alxsh/balmer-usb-sdr/doc/trx2-dds-1-sch.pdf

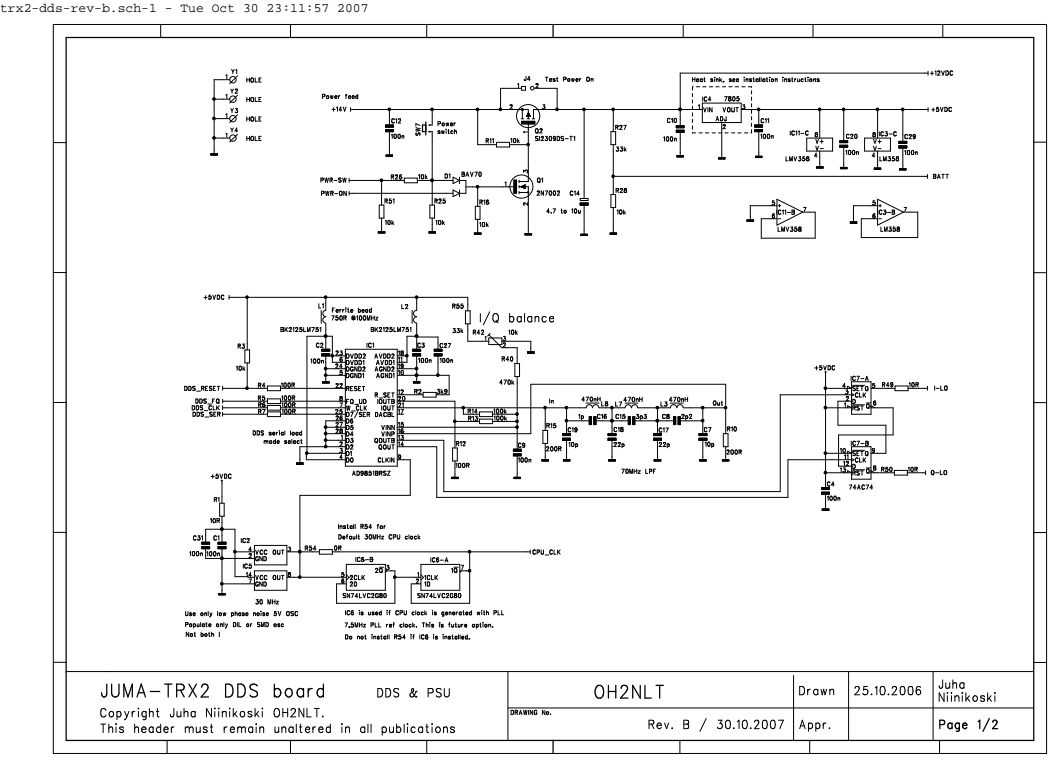
[picture p10: page 1]

trx2-dds-rev-b.sch-1 - Tue Oct 30 23:11:57 2007
