alxsh/balmer-usb-sdr/circuit/ADC_DSP.brd

## EAGLE design circuit/ADC_DSP.brd (2015-01-28)

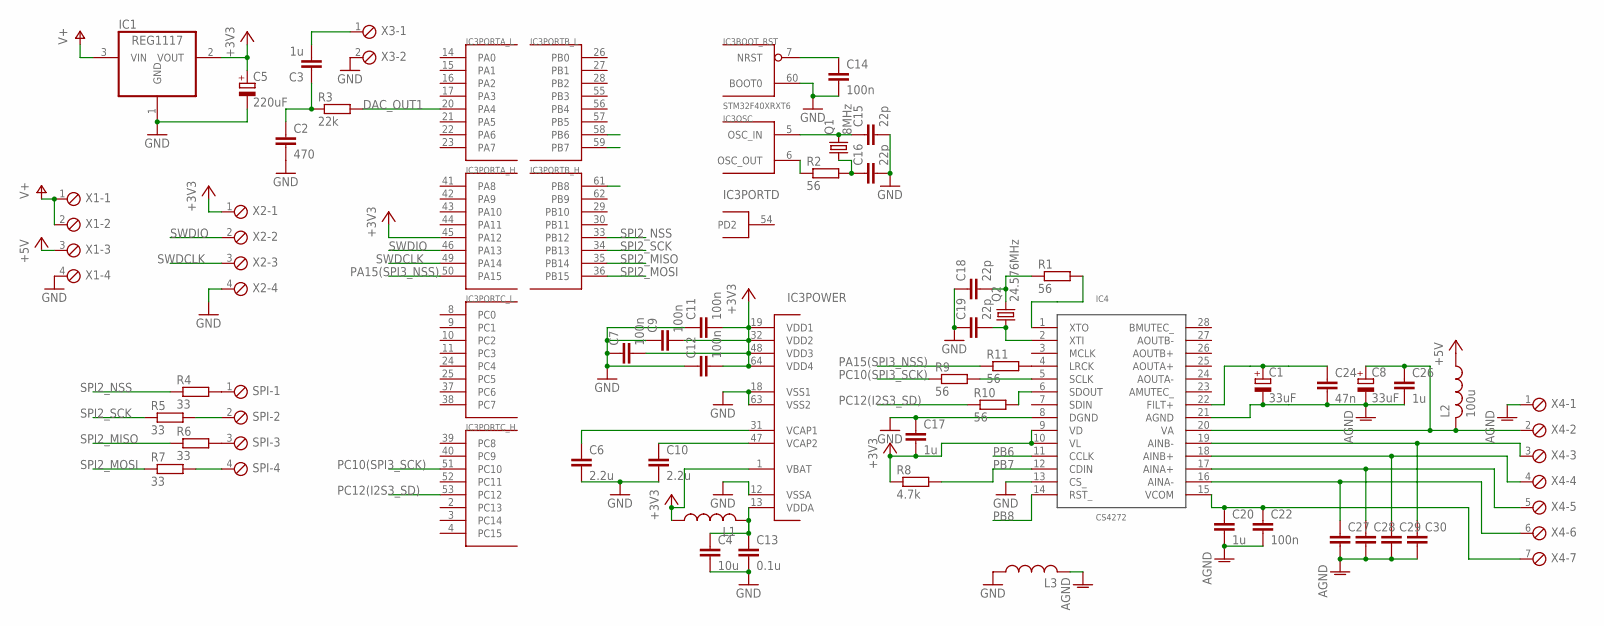
[picture p11: schematic ADC_DSP.sch]

Parts:
C1, C8: 33uF; 153CLV-0605
C2: 470; C0603
C3, C17, C20, C26: 1u; C0603
C4: 10u; C0805
C5: 220uF; 153CLV-0605
C6, C10: 2.2u; C0603
C7, C9, C11, C12, C14, C22: 100n; C0603
C13: 0.1u; C0603
C15, C16, C18, C19: 22p; C0603
C24: 47n; C0805
C27, C28, C29, C30: C-EUC0805; C0805
IC1: REG1117; SOT223
IC3: STM32F40XRXT6; TQFP64
IC4: CS4272; TSSOP28
L1, L3: L-USL2012C; L2012C
L2: 100u; 0207/12
Q1: 8MHz; HC49/S
Q2: 24.576MHz; HC49/S
R1, R2, R9, R10, R11: 56; R0603
R3: 22k; R0603
R4, R5, R6, R7: 33; R0603
R8: 4.7k; R0603
SPI: MPT4; 4POL254
X1, X2: MPT4; 4POL254
X3: MPT2; 2POL254
X4: MPT7; 7POL254

Connections:
+3V3: C5.+, C7.2, C9.2, C11.2, C12.2, C17.2, IC1.2 (VOUT), IC3.1 (VBAT), IC3.19 (VDD1), IC3.32 (VDD2), IC3.45 (PA12), IC3.48 (VDD3), IC3.64 (VDD4), IC4.9 (VD), IC4.10 (VL), L1.1, R8.1, X2.1
+5V: L2.1, X1.3
AGND: C1.-, C8.-, C20.2, C22.2, C24.2, C26.2, C27.2, C28.2, C29.2, C30.2, IC4.21 (AGND), L3.2, X4.1
AINA+: C28.1, IC4.17 (AINA+), X4.5
AINB+: C29.1, IC4.18 (AINB+), X4.4
AVCC: C8.+, C26.1, IC4.20 (VA), L2.2, X4.2
DAC_OUT1: IC3.20 (PA4), R3.2
GND: C2.2, C4.2, C5.-, C6.2, C7.1, C9.1, C10.2, C11.1, C12.1, C13.2, C14.2, C15.2, C16.2, C17.1, C18.1, C19.1, IC1.1 (GND), IC3.12 (VSSA), IC3.18 (VSS1), IC3.60 (BOOT0), IC3.63 (VSS2), IC4.8 (DGND), IC4.13 (CS_), L3.1, X1.4, X2.4, X3.2
unnamed: C10.1, IC3.47 (VCAP2)
unnamed: C6.1, IC3.31 (VCAP1)
unnamed: C4.1, C13.1, IC3.13 (VDDA), L1.2
unnamed: C14.1, IC3.7 (NRST)
unnamed: C15.1, IC3.5 (OSC_IN), Q1.2
unnamed: C16.1, Q1.1, R2.2
unnamed: C19.2, IC4.2 (XTI), Q2.1
unnamed: C18.2, Q2.2, R1.1
unnamed: IC4.4 (LRCK), R11.2
unnamed: IC4.5 (SCLK), R9.2
unnamed: IC4.6 (SDOUT), R10.2
unnamed: C1.+, C24.1, IC4.22 (FILT+)
unnamed: C30.1, IC4.19 (AINB-), X4.3
unnamed: C3.2, X3.1
unnamed: IC4.1 (XTO), R1.2
unnamed: C27.1, IC4.16 (AINA-), X4.6
unnamed: IC3.6 (OSC_OUT), R2.1
unnamed: R4.2, SPI.1
unnamed: R5.2, SPI.2
unnamed: R6.2, SPI.3
unnamed: C2.1, C3.1, R3.1
unnamed: R7.2, SPI.4
PA15(SPI3_NSS): IC3.50 (PA15), R11.1
PB6: IC3.58 (PB6), IC4.11 (CCLK)
PB7: IC3.59 (PB7), IC4.12 (CDIN), R8.2
PB8: IC3.61 (PB8), IC4.14 (RST_)
PC10(SPI3_SCK): IC3.51 (PC10), R9.1
PC12(I2S3_SD): IC3.53 (PC12), R10.1
SPI2_MISO: IC3.35 (PB14), R6.1
SPI2_MOSI: IC3.36 (PB15), R7.1
SPI2_NSS: IC3.33 (PB12), R4.1
SPI2_SCK: IC3.34 (PB13), R5.1
SWDCLK: IC3.49 (PA14), X2.3
SWDIO: IC3.46 (PA13), X2.2
V+: IC1.3 (VIN), X1.1, X1.2
VCOM: C20.1, C22.1, IC4.15 (VCOM), X4.7

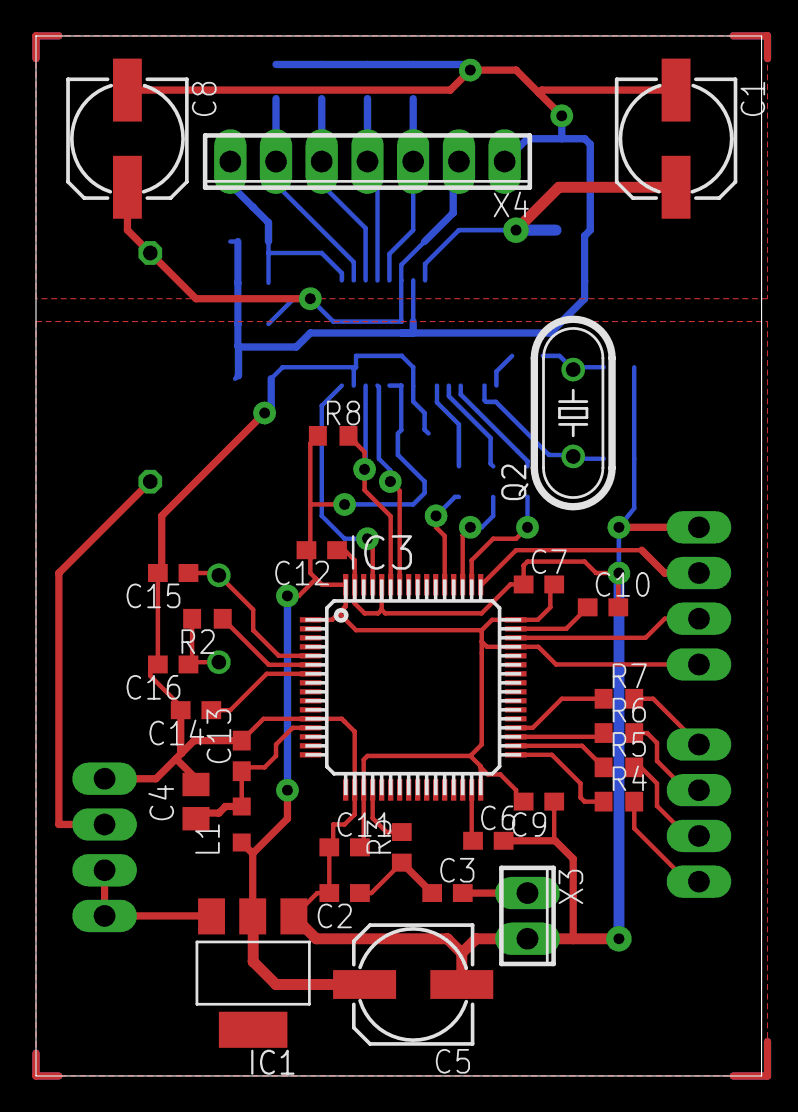
[picture p12: board ADC_DSP.brd from above]

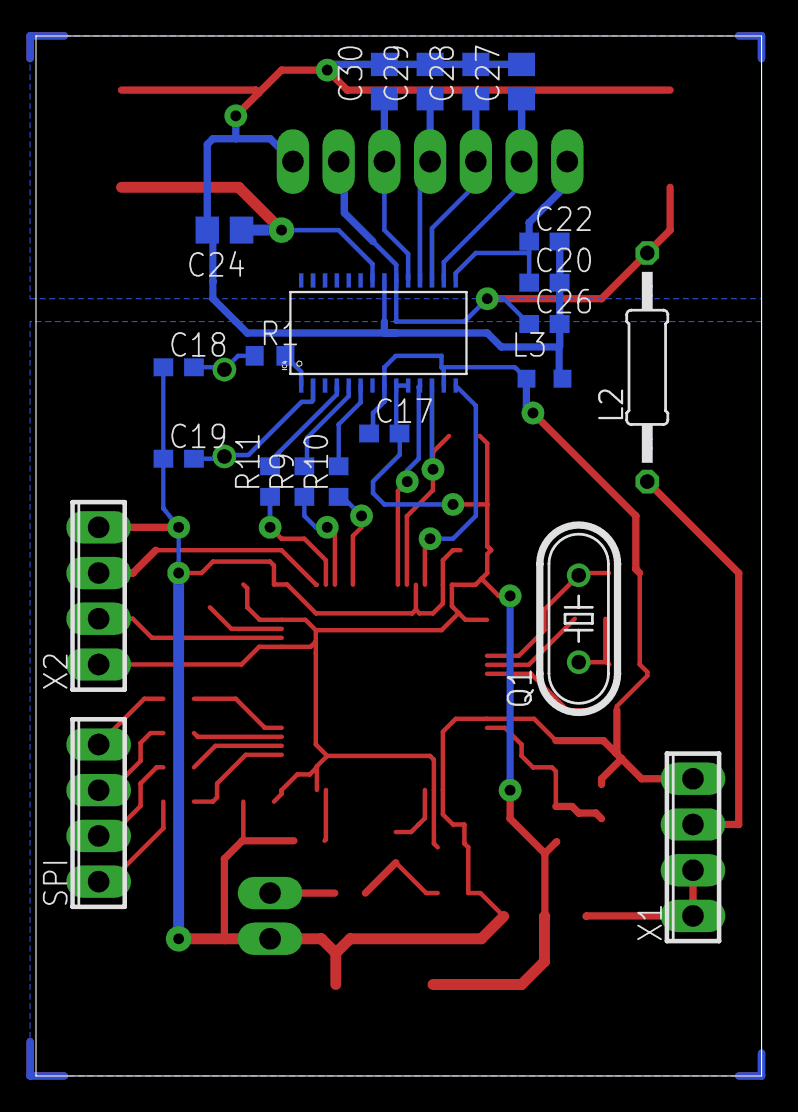
[picture p13: board ADC_DSP.brd from below]

Board: 2 copper layers, 40.3 x 57.8 mm, 51 parts (22 on the bottom side), 44 nets.
