alxsh/balmer-usb-sdr/circuit/mixer.brd

## EAGLE design circuit/mixer.brd (2014-12-01)

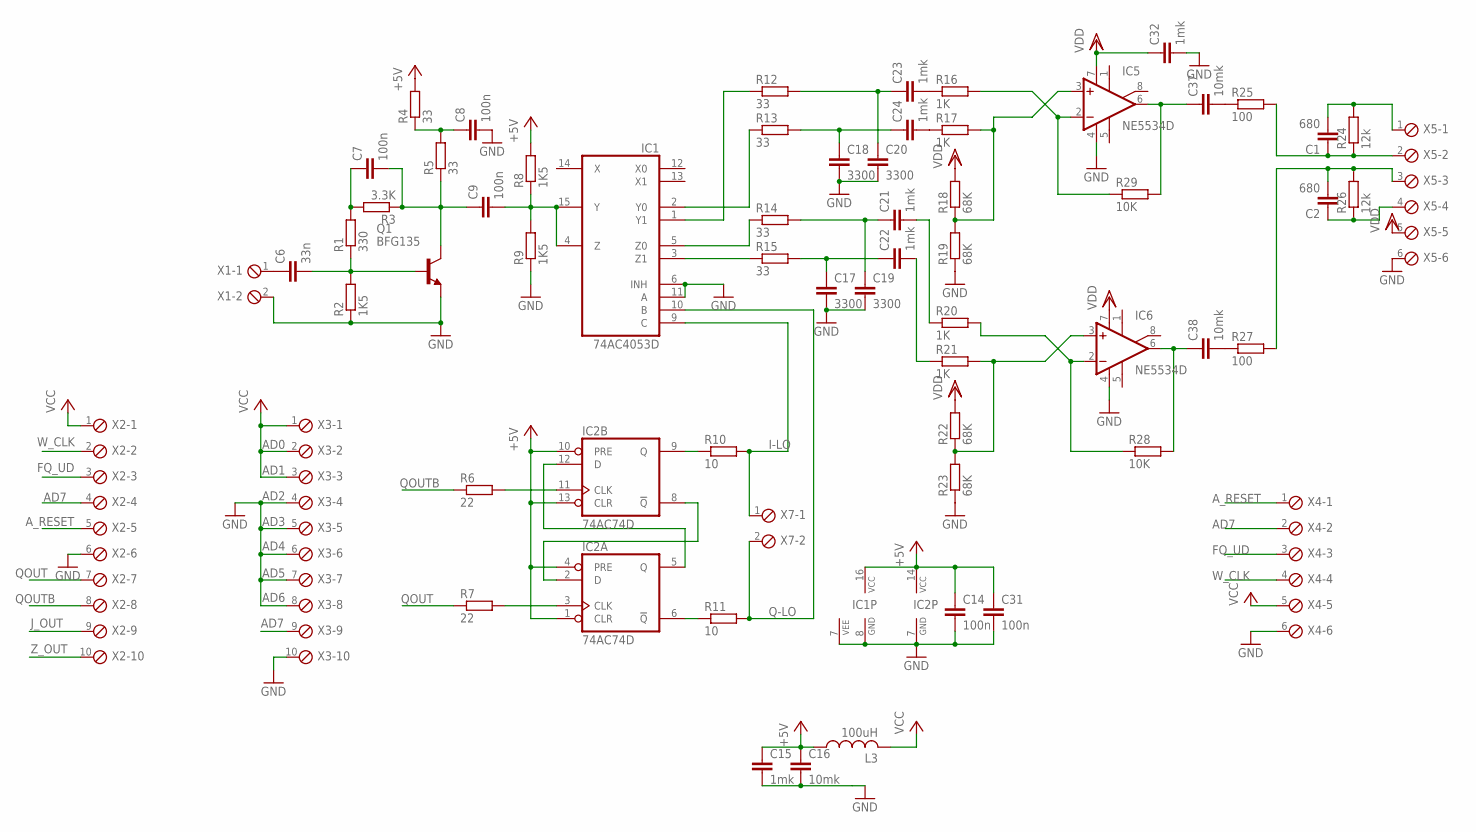
[picture p14: schematic mixer.sch]

Parts:
C1, C2: 680; C0805
C6: 33n; C0805
C7, C8, C9, C14, C31: 100n; C0603
C15, C21, C22, C23, C24, C32: 1mk; C0603
C16, C37, C38: 10mk; C0805
C17, C18, C19, C20: 3300; C0805
IC1: 74AC4053D; SO16
IC2: 74AC74D; SO14
IC5, IC6: NE5534D; SO08
L3: 100uH; 0207/12
Q1: BFG135; SOT223
R1: 330; R0603
R2, R8, R9: 1K5; R0603
R3: 3.3K; R0603
R4, R5, R12, R13, R14, R15: 33; R0603
R6, R7: 22; R0603
R10, R11: 10; R0603
R16, R17, R20, R21: 1K; R0603
R18, R19, R22, R23: 68K; R0603
R24, R26: 12k; R0603
R25, R27: 100; R0603
R28, R29: 10K; R0603
X1, X7: MPT2; 2POL254
X2, X3: MPT10; 10POL254
X4, X5: MPT6; 6POL254

Connections:
+5V: C14.1, C15.1, C16.1, C31.1, IC1.16 (VCC), IC2.1 (CLR), IC2.4 (PRE), IC2.10 (PRE), IC2.13 (CLR), IC2.14 (VCC), L3.1, R4.2, R8.2
AD7: X2.4, X4.2
A_RESET: X2.5, X4.1
FQ_UD: X2.3, X4.3
GND: C8.2, C14.2, C15.2, C16.2, C17.2, C18.2, C19.2, C20.2, C31.2, C32.2, IC1.6 (INH), IC1.7 (VEE), IC1.8 (GND), IC1.11 (A), IC2.7 (GND), IC5.4 (V-), IC6.4 (V-), Q1.1 (E), Q1.3 (E), R2.1, R9.1, R19.1, R23.1, X1.2, X2.6, X3.4, X3.5, X3.6, X3.7, X3.8, X3.10, X4.6, X5.6
I-LO: IC1.9 (C), R10.2, X7.1
J_OUT: X2.9
unnamed: IC2.5 (Q), IC2.12 (D)
unnamed: IC2.2 (D), IC2.8 (!Q)
unnamed: IC2.11 (CLK), R6.2
unnamed: IC2.3 (CLK), R7.2
unnamed: IC1.3 (Z1), R15.1
unnamed: C9.2, IC1.4 (Z), IC1.15 (Y), R8.1, R9.2
unnamed: C7.1, R1.2, R3.2
unnamed: IC1.5 (Z0), R14.1
unnamed: IC1.2 (Y0), R13.1
unnamed: IC1.1 (Y1), R12.1
unnamed: C17.1, C22.1, R15.2
unnamed: C19.1, C21.1, R14.2
unnamed: C18.1, C24.1, R13.2
unnamed: C20.1, C23.1, R12.2
unnamed: IC5.3 (+IN), R17.2, R18.1, R19.2
unnamed: C38.1, IC6.6 (OUT), R28.2
unnamed: IC5.2 (-IN), R16.2, R29.1
unnamed: C37.1, IC5.6 (OUT), R29.2
unnamed: C23.2, R16.1
unnamed: C21.2, R20.1
unnamed: C22.2, R21.1
unnamed: IC6.2 (-IN), R20.2, R28.1
unnamed: IC6.3 (+IN), R21.2, R22.1, R23.2
unnamed: C6.1, X1.1
unnamed: C24.2, R17.1
unnamed: C37.2, R25.1
unnamed: C1.1, R24.1, R25.2, X5.2
unnamed: C1.2, R24.2, X5.1
unnamed: C2.1, R26.1, X5.4
unnamed: C2.2, R26.2, R27.2, X5.3
unnamed: IC2.9 (Q), R10.1
unnamed: IC2.6 (!Q), R11.1
unnamed: C38.2, R27.1
unnamed: C7.2, C9.1, Q1.4 (C), R3.1, R5.1
unnamed: C8.1, R4.1, R5.2
unnamed: C6.2, Q1.2 (B), R1.1, R2.2
Q-LO: IC1.10 (B), R11.2, X7.2
QOUT: R7.1, X2.7
QOUTB: R6.1, X2.8
VCC: L3.2, X2.1, X3.1, X3.2, X3.3, X4.5
VDD: C32.1, IC5.7 (V+), IC6.7 (V+), R18.2, R22.2, X5.5
W_CLK: X2.2, X4.4
Z_OUT: X2.10

Notes on the sheet:
AD0
AD1
AD2
AD3
AD4
AD5
AD6
AD7

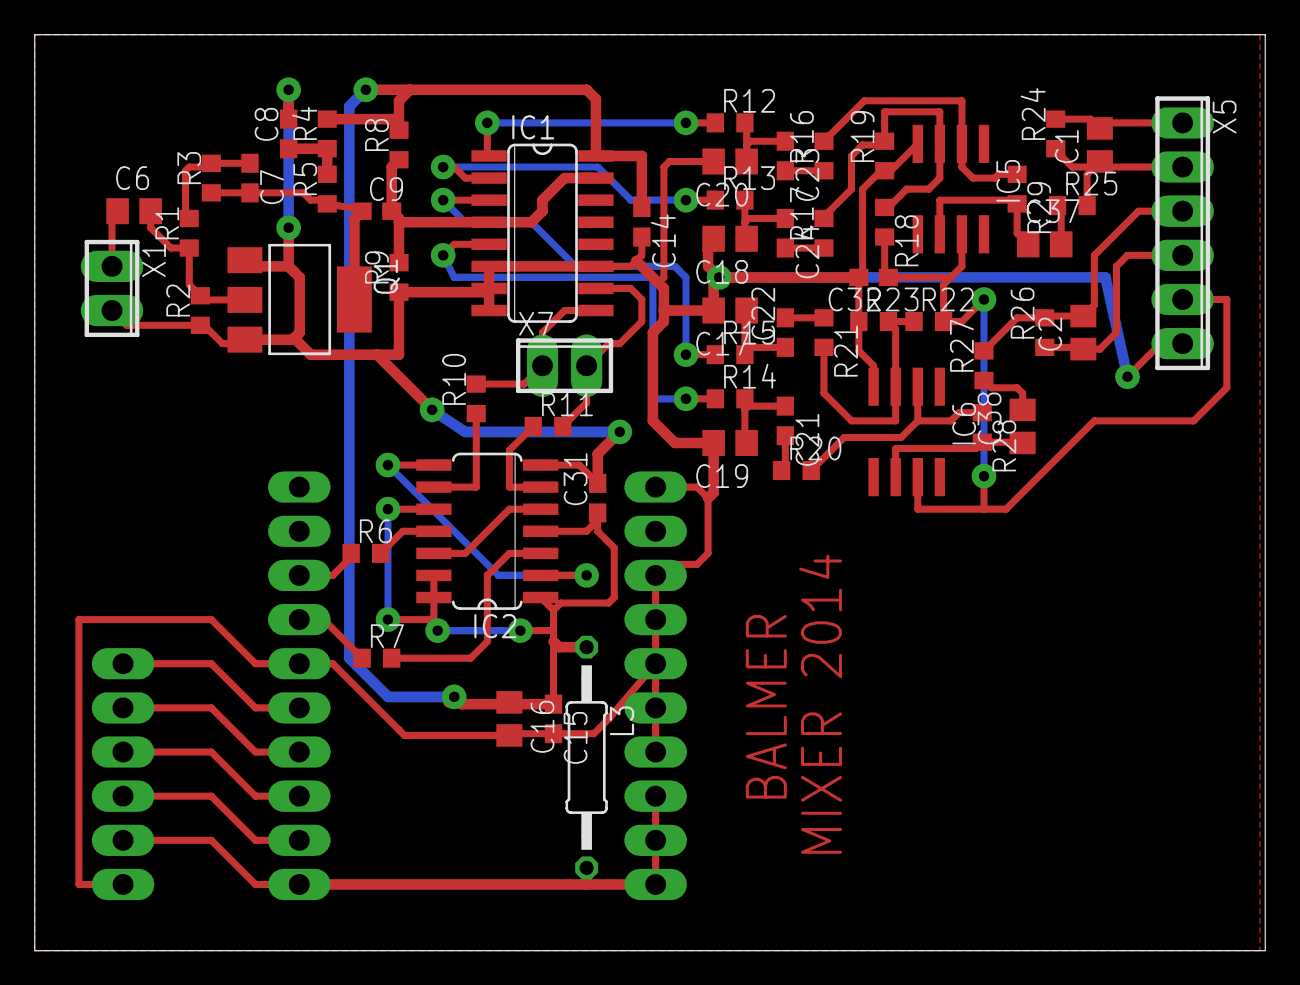
[picture p15: board mixer.brd from above]

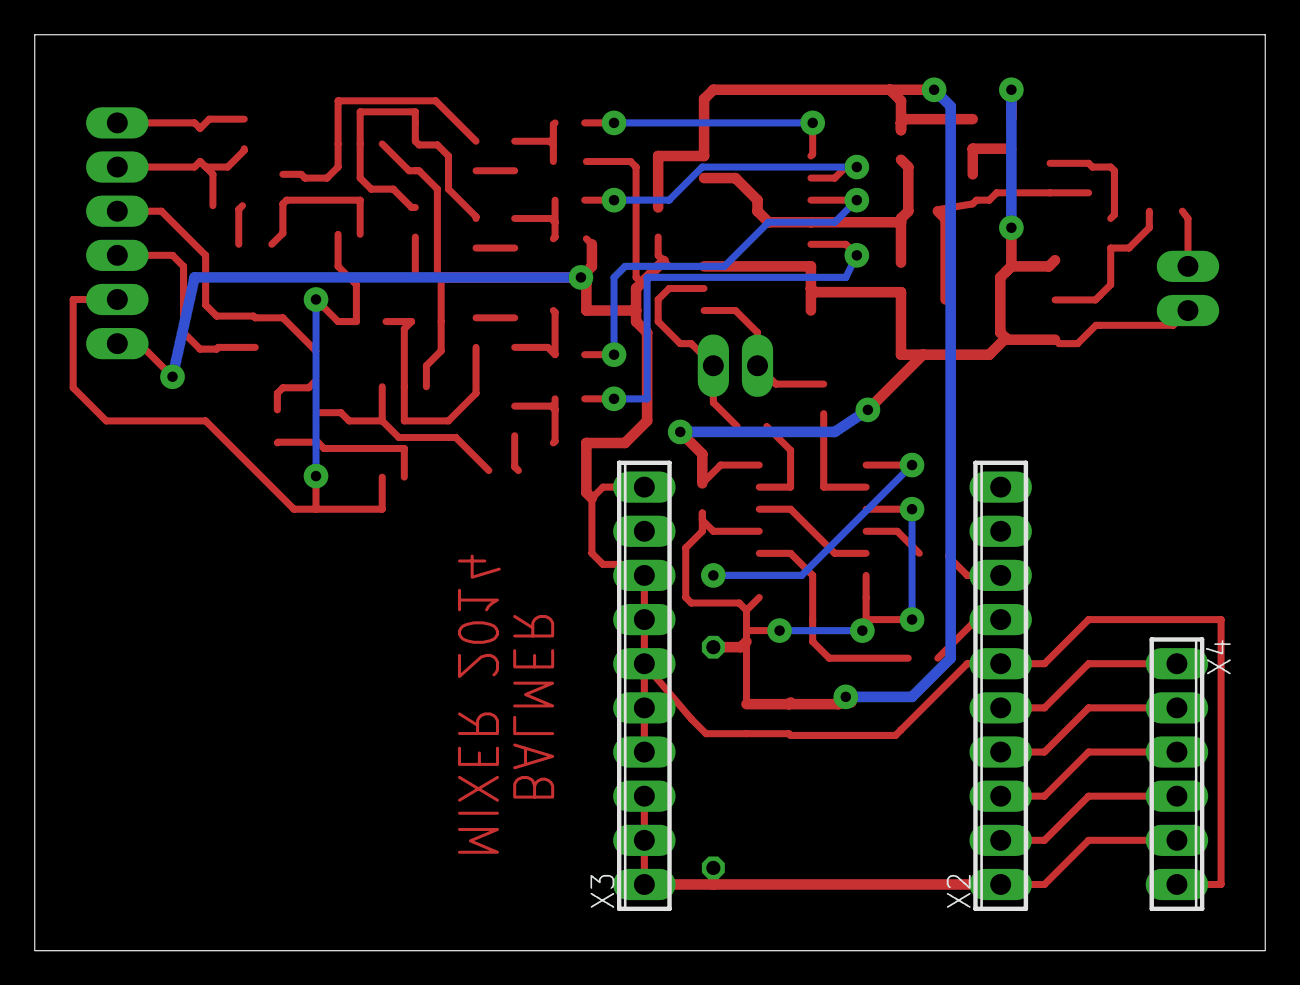
[picture p16: board mixer.brd from below]

Board: 2 copper layers, 70.8 x 52.7 mm, 62 parts (3 on the bottom side), 48 nets.
