alxsh/balmer-usb-sdr/circuit/dual_supply.brd

## EAGLE design circuit/dual_supply.brd (2014-11-25)

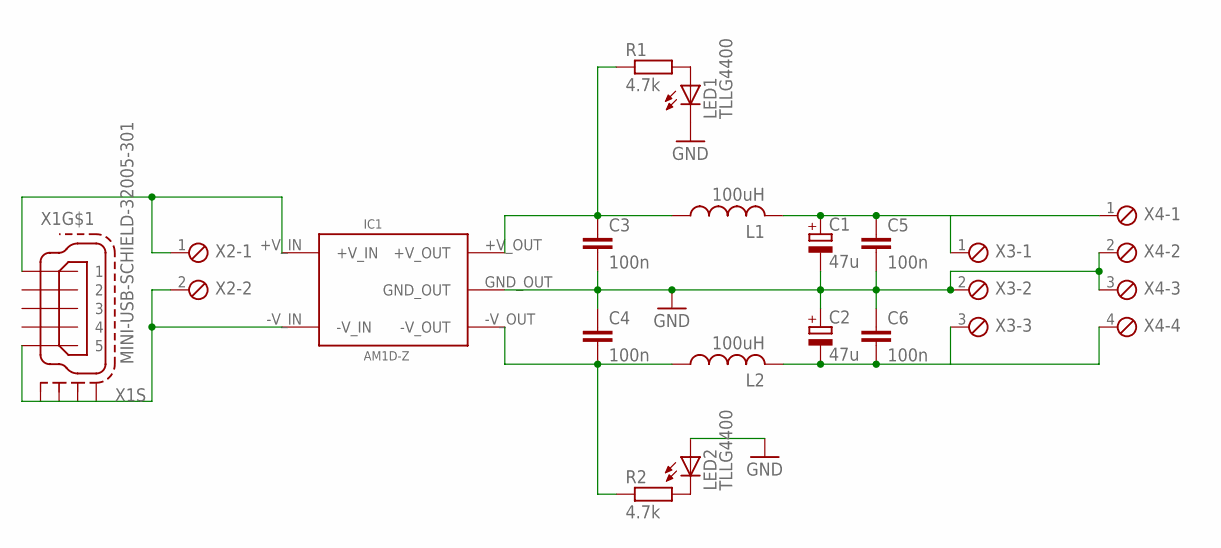
[picture p17: schematic dual_supply.sch]

Parts:
C1, C2: 47u; E3,5-8
C3, C4, C5, C6: 100n; C0805
IC1: AM1D-Z
L1, L2: 100uH; IR-2
LED1, LED2: TLLG4400; LED3MM
R1, R2: 4.7k; R0805
X1: MINI-USB-SCHIELD-32005-301; 32005-301
X2: MPT2; 2POL254
X3: MPT3; 3POL254
X4: MPT4; 4POL254

Connections:
+5V: C1.+, C5.1, L1.2, X3.1, X4.1
-5V: C2.-, C6.2, L2.2, X3.3, X4.4
GND: C1.-, C2.+, C3.2, C4.1, C5.2, C6.1, IC1.GND_OUT, LED1.K (C), LED2.A, X3.2, X4.2, X4.3
unnamed: IC1.-V_IN, X1.5, X1.M1 (S1), X1.M2 (S2), X1.M3 (S3), X1.M4 (S4), X2.2
unnamed: IC1.+V_IN, X1.1, X2.1
unnamed: C3.1, IC1.+V_OUT, L1.1, R1.1
unnamed: LED1.A, R1.2
unnamed: C4.2, IC1.-V_OUT, L2.1, R2.1
unnamed: LED2.K (C), R2.2

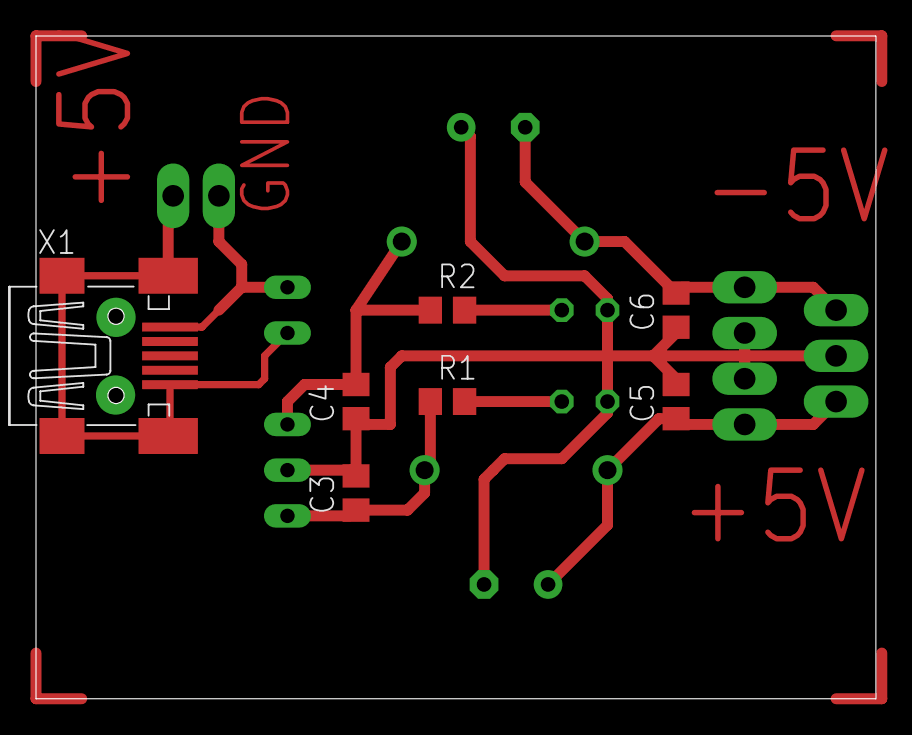
[picture p18: board dual_supply.brd from above]

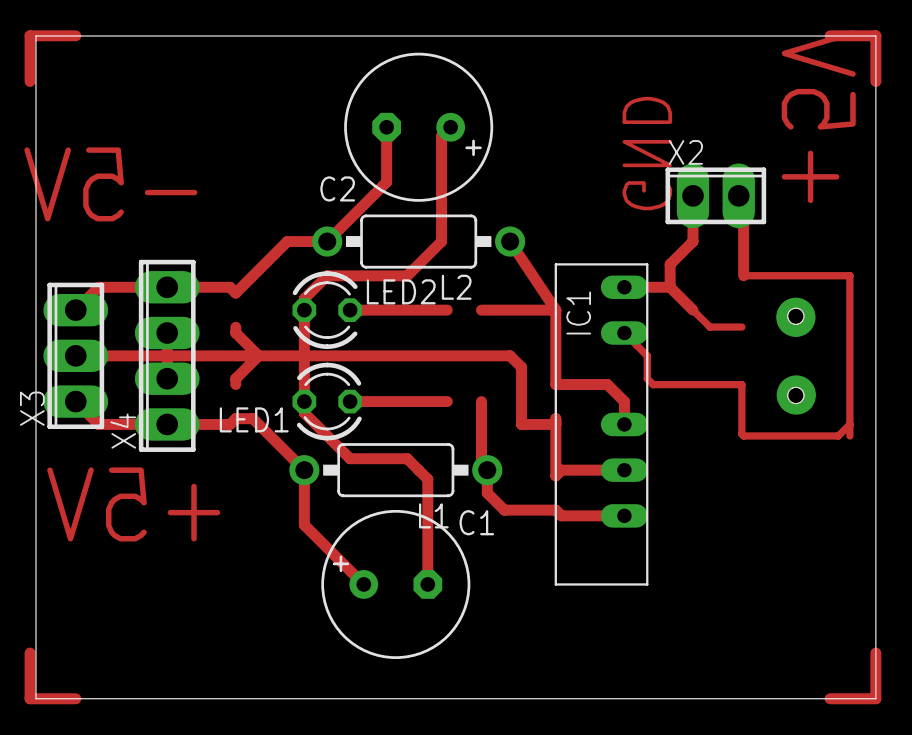
[picture p19: board dual_supply.brd from below]

Board: 2 copper layers, 46.7 x 36.8 mm, 17 parts (10 on the bottom side), 9 nets.
