alxsh/balmer-usb-sdr/circuit/cs4272_test.brd

## EAGLE design circuit/cs4272_test.brd (2014-10-25)

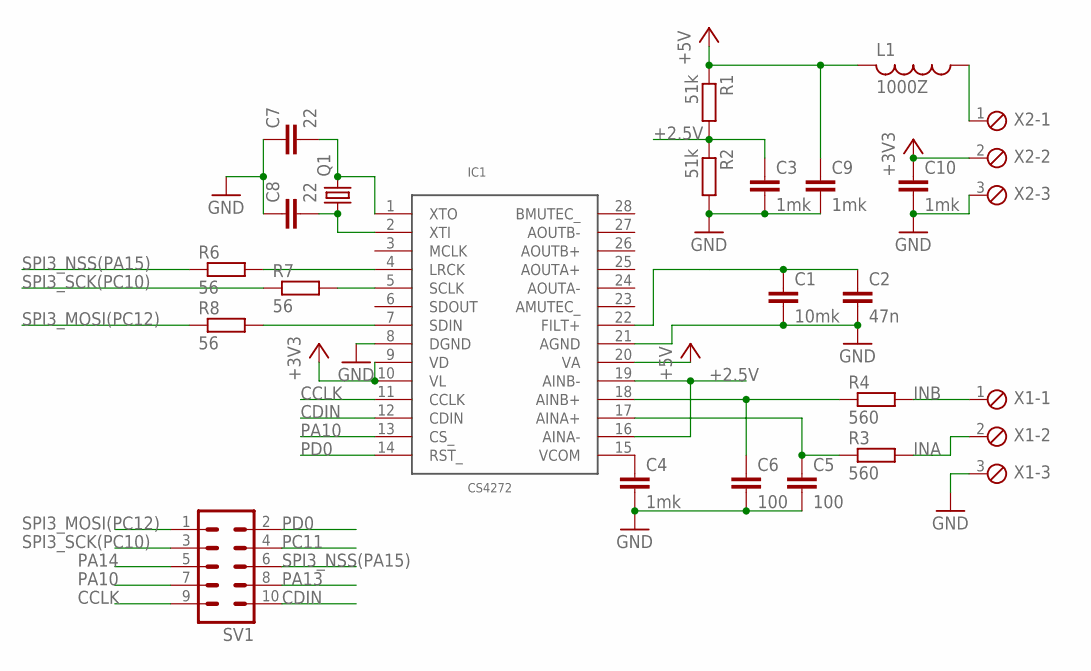
[picture p20: schematic cs4272_test.sch]

Parts:
C1: 10mk; C0805
C2: 47n; C0805
C3, C4, C9, C10: 1mk; C0603
C5, C6: 100; C0805
C7, C8: 22; C0603
IC1: CS4272; TSSOP28
L1: 1000Z; C0805
Q1: CRYSTALHC49S; HC49/S
R1, R2: 51k; R0603
R3, R4: 560; R0603
R6, R7, R8: 56; R0603
SV1: ML10
X1, X2: MPT3; 3POL254

Connections:
+2.5V: C3.1, IC1.16 (AINA-), IC1.19 (AINB-), R1.2, R2.1
+3V3: C10.1, IC1.9 (VD), IC1.10 (VL), X2.2
+5V: C9.1, IC1.20 (VA), L1.2, R1.1
CCLK: IC1.11 (CCLK), SV1.9
CDIN: IC1.12 (CDIN), SV1.10
GND: C1.2, C2.2, C3.2, C4.2, C5.2, C6.2, C7.1, C8.1, C9.2, C10.2, IC1.8 (DGND), IC1.21 (AGND), R2.2, X1.3, X2.3
INA: R3.2, X1.2
INB: R4.2, X1.1
unnamed: C1.1, C2.1, IC1.22 (FILT+)
unnamed: C4.1, IC1.15 (VCOM)
unnamed: C6.1, IC1.18 (AINB+), R4.1
unnamed: C5.1, IC1.17 (AINA+), R3.1
unnamed: C8.2, IC1.2 (XTI), Q1.1
unnamed: C7.2, IC1.1 (XTO), Q1.2
unnamed: L1.1, X2.1
unnamed: IC1.4 (LRCK), R6.2
unnamed: IC1.5 (SCLK), R7.2
unnamed: IC1.7 (SDIN), R8.2
PA10: IC1.13 (CS_), SV1.7
PA13: SV1.8
PA14: SV1.5
PC11: SV1.4
PD0: IC1.14 (RST_), SV1.2
SPI3_MOSI(PC12): R8.1, SV1.1
SPI3_NSS(PA15): R6.1, SV1.6
SPI3_SCK(PC10): R7.1, SV1.3

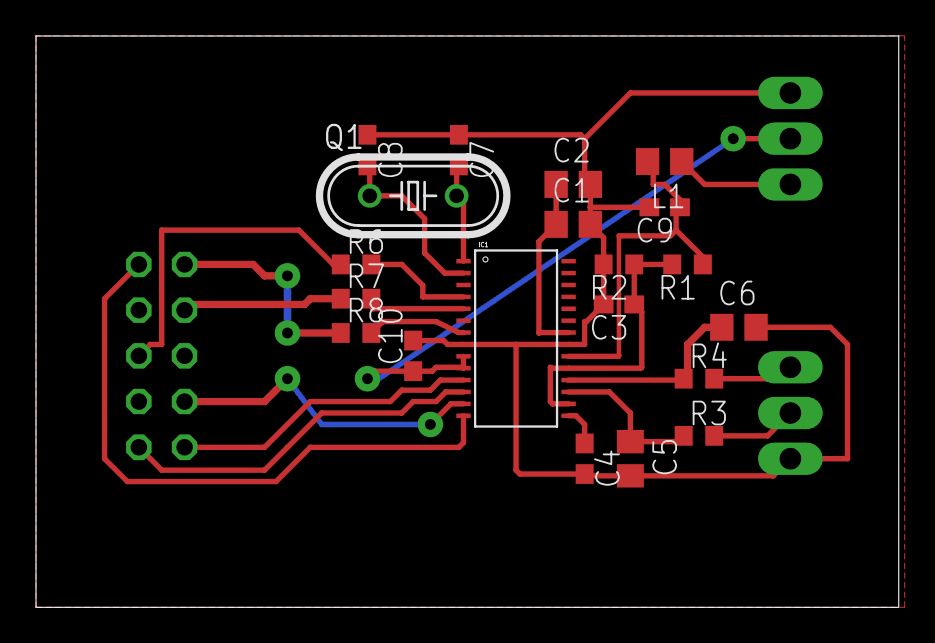
[picture p21: board cs4272_test.brd from above]

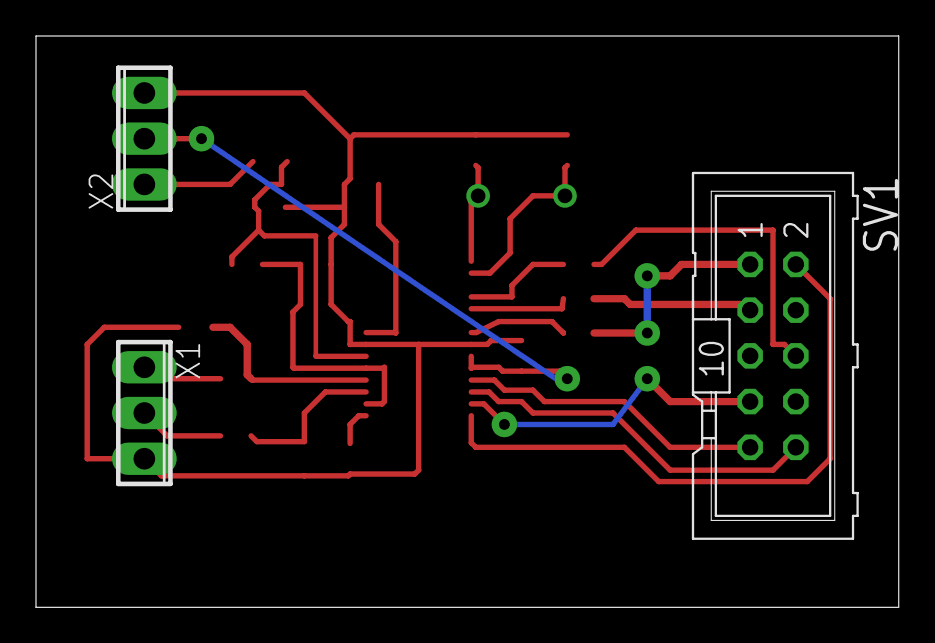
[picture p22: board cs4272_test.brd from below]

Board: 2 copper layers, 47.9 x 31.7 mm, 23 parts (3 on the bottom side), 23 nets.
