alxsh/balmer-usb-sdr/circuit/dds_ad9958.brd

## EAGLE design circuit/dds_ad9958.brd (2014-09-28)

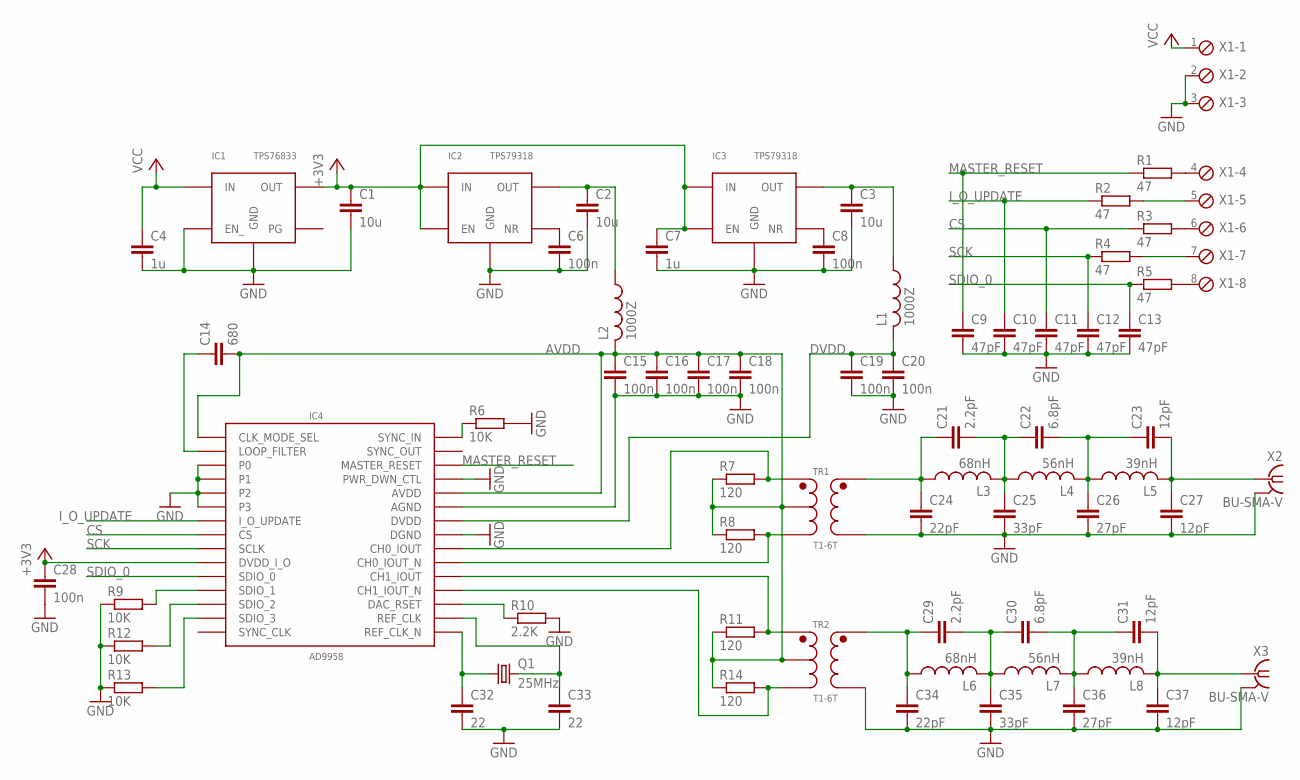
[picture p23: schematic dds_ad9958.sch]

Parts:
C1, C2, C3: 10u; C0805
C4, C7: 1u; C0603
C6, C8, C15, C16, C17, C18, C19, C20, C28: 100n; C0603
C9, C10, C11, C12, C13: 47pF; C0805
C14: 680; C0805
C21, C29: 2.2pF; C0805
C22, C30: 6.8pF; C0805
C23, C27, C31, C37: 12pF; C0805
C24, C34: 22pF; C0805
C25, C35: 33pF; C0805
C26, C36: 27pF; C0805
C32, C33: 22; C0603
IC1: TPS76833; SO8
IC2, IC3: TPS79318; SOT23-5
IC4: AD9958; CP-56-1
L1, L2: 1000Z; C0805
L3, L6: 68nH; C0805
L4, L7: 56nH; C0805
L5, L8: 39nH; C0805
Q1: 25MHz; HC49/S
R1, R2, R3, R4, R5: 47; R0603
R6, R9, R12, R13: 10K; R0603
R7, R8, R11, R14: 120; R0603
R10: 2.2K; R0603
TR1, TR2: T1-6T; KK81
X1: MPT8; 8POL254
X2, X3: BU-SMA-V

Connections:
+3V3: C1.1, C7.1, C28.1, IC1.5 (OUT), IC1.6 (OUT), IC2.1 (IN), IC2.3 (EN), IC3.1 (IN), IC3.3 (EN), IC4.P$49 (DVDD_I_O)
AVDD: C14.2, C15.1, C16.1, C17.1, C18.1, IC4.P$5 (AVDD), IC4.P$7 (AVDD), IC4.P$11 (AVDD), IC4.P$15 (AVDD), IC4.P$19 (AVDD), IC4.P$21 (AVDD), IC4.P$24 (CLK_MODE_SEL), IC4.P$26 (AVDD), IC4.P$29 (AVDD), IC4.P$30 (AVDD), IC4.P$31 (AVDD), IC4.P$33 (AVDD), IC4.P$35 (AVDD), IC4.P$36 (AVDD), IC4.P$37 (AVDD), IC4.P$39 (AVDD), L2.2, R7.1, R8.1, R11.1, R14.1, TR1.P$2 (SEC_CT), TR2.P$2 (SEC_CT)
CS: C11.1, IC4.P$47 (CS), R3.1
DVDD: C19.1, C20.1, IC4.P$45 (DVDD), IC4.P$55 (DVDD), L1.2
GND: C1.2, C2.2, C3.2, C4.2, C6.2, C7.2, C8.2, C9.2, C10.2, C11.2, C12.2, C13.2, C15.2, C16.2, C17.2, C18.2, C19.2, C20.2, C24.2, C25.2, C26.2, C27.2, C28.2, C32.2, C33.2, C34.2, C35.2, C36.2, C37.2, IC1.1 (GND), IC1.2 (EN_), IC2.2 (GND), IC3.2 (GND), IC4.P$4 (PWR_DWN_CTL), IC4.P$6 (AGND), IC4.P$10 (AGND), IC4.P$12 (AGND), IC4.P$16 (AGND), IC4.P$18 (AGND), IC4.P$20 (AGND), IC4.P$25 (AGND), IC4.P$40 (P0), IC4.P$41 (P1), IC4.P$42 (P2), IC4.P$43 (P3), IC4.P$44 (DGND), IC4.P$56 (DGND), IC4.PAD (AGND), R6.2, R9.1, R10.2, R12.1, R13.1, TR1.P$6 (PRI), TR2.P$6 (PRI), X1.2, X1.3, X2.2, X2.3 (2), X2.4 (2), X2.5 (2), X3.2, X3.3 (2), X3.4 (2), X3.5 (2)
I_O_UPDATE: C10.1, IC4.P$46 (I_O_UPDATE), R2.1
MASTER_RESET: C9.1, IC4.P$3 (MASTER_RESET), R1.1
unnamed: C32.1, IC4.P$22 (REF_CLK_N), Q1.1
unnamed: C21.1, C24.1, L3.1, TR1.P$4 (PRI_DOT)
unnamed: IC4.P$8 (CH0_IOUT), R7.2, TR1.P$3 (SEC_DOT)
unnamed: C6.1, IC2.4 (NR)
unnamed: C8.1, IC3.4 (NR)
unnamed: C2.1, IC2.5 (OUT), L2.1
unnamed: IC4.P$9 (CH0_IOUT_N), R8.2, TR1.P$1 (SEC)
unnamed: C3.1, IC3.5 (OUT), L1.1
unnamed: IC4.P$13 (CH1_IOUT), R11.2, TR2.P$3 (SEC_DOT)
unnamed: IC4.P$14 (CH1_IOUT_N), R14.2, TR2.P$1 (SEC)
unnamed: C21.2, C22.1, C25.1, L3.2, L4.1
unnamed: IC4.P$17 (DAC_RSET), R10.1
unnamed: IC4.P$1 (SYNC_IN), R6.1
unnamed: C14.1, IC4.P$27 (LOOP_FILTER)
unnamed: C33.1, IC4.P$23 (REF_CLK), Q1.2
unnamed: C22.2, C23.1, C26.1, L4.2, L5.1
unnamed: C23.2, C27.1, L5.2, X2.1
unnamed: C29.1, C34.1, L6.1, TR2.P$4 (PRI_DOT)
unnamed: C29.2, C30.1, C35.1, L6.2, L7.1
unnamed: C30.2, C31.1, C36.1, L7.2, L8.1
unnamed: C31.2, C37.1, L8.2, X3.1
unnamed: R3.2, X1.6
unnamed: R5.2, X1.8
unnamed: R1.2, X1.4
unnamed: R2.2, X1.5
unnamed: R4.2, X1.7
SCK: C12.1, IC4.P$48 (SCLK), R4.1
SDIO_0: C13.1, IC4.P$50 (SDIO_0), R5.1
SDIO_1: IC4.P$51 (SDIO_1), R9.2
SDIO_2: IC4.P$52 (SDIO_2), R12.2
SDIO_3: IC4.P$53 (SDIO_3), R13.2
VCC: C4.1, IC1.3 (IN), IC1.4 (IN), X1.1

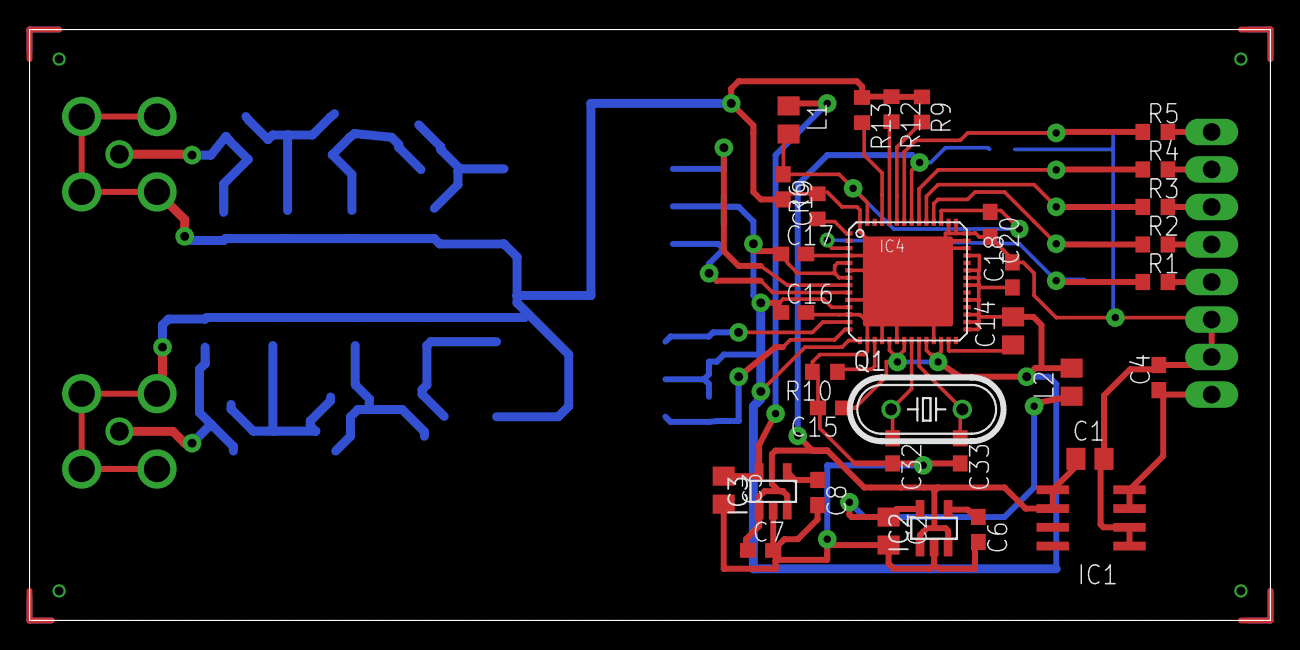
[picture p24: board dds_ad9958.brd from above]

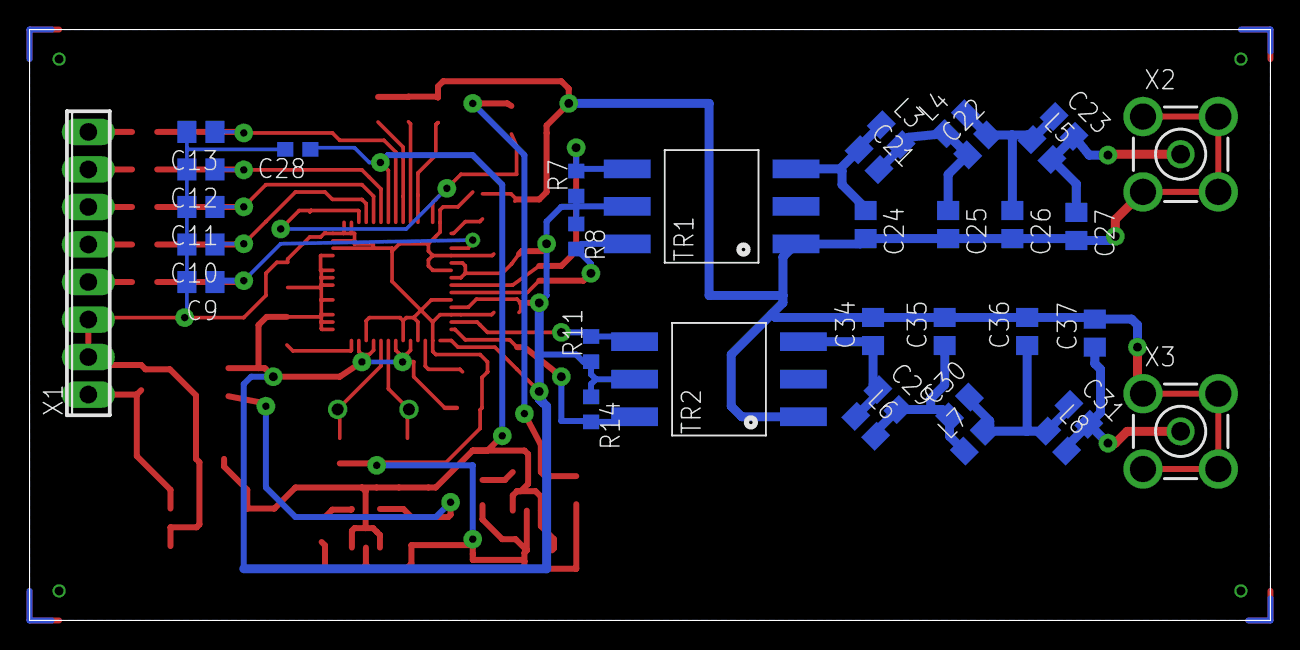
[picture p25: board dds_ad9958.brd from below]

Board: 2 copper layers, 84.0 x 40.0 mm, 68 parts (35 on the bottom side), 39 nets.
