alxsh/balmer-usb-sdr/code/mycode/src/my_hardware.c

// balmer@inbox.ru 2013 TermometerHygrometer

#include "usb_lib.h"
#include "usb_prop.h"
#include "usb_desc.h"
#include "hw_config.h"
#include "usb_core.h"
#include "usb_pwr.h"

/* Private variables ---------------------------------------------------------*/
ErrorStatus HSEStartUpStatus;

__IO uint32_t packet_sent=1;
__IO uint32_t packet_receive=1;
uint8_t Receive_Buffer[64];

/* Extern variables ----------------------------------------------------------*/
/* Private function prototypes -----------------------------------------------*/
void Set_USBClock(void);
void USB_Interrupts_Config(void);

/* Private functions ---------------------------------------------------------*/
void UsbInitClockAndSystem(void)
{
#if defined(USB_USE_EXTERNAL_PULLUP)
  GPIO_InitTypeDef  GPIO_InitStructure;
#endif /* USB_USE_EXTERNAL_PULLUP */ 
  
  /*!< At this stage the microcontroller clock setting is already configured, 
       this is done through SystemInit() function which is called from startup
       file (startup_stm32f10x_xx.s) before to branch to application main.
       To reconfigure the default setting of SystemInit() function, refer to
       system_stm32f10x.c file
     */   
#if defined(STM32L1XX_MD) || defined(STM32L1XX_HD)|| defined(STM32L1XX_MD_PLUS)
  /* Enable the SYSCFG module clock */
  RCC_APB2PeriphClockCmd(RCC_APB2Periph_SYSCFG, ENABLE);
#endif /* STM32L1XX_XD */ 
      
#if defined(USB_USE_EXTERNAL_PULLUP)
  /* Enable the USB disconnect GPIO clock */
  RCC_AHBPeriphClockCmd(RCC_AHBPeriph_GPIO_DISCONNECT, ENABLE);

  /* USB_DISCONNECT used as USB pull-up */
  GPIO_InitStructure.GPIO_Pin = USB_DISCONNECT_PIN;
  GPIO_InitStructure.GPIO_Mode = GPIO_Mode_OUT;
  GPIO_InitStructure.GPIO_Speed = GPIO_Speed_2MHz;
  GPIO_InitStructure.GPIO_OType = GPIO_OType_PP;
  GPIO_InitStructure.GPIO_PuPd = GPIO_PuPd_NOPULL;
  GPIO_Init(USB_DISCONNECT, &GPIO_InitStructure);  
#endif /* USB_USE_EXTERNAL_PULLUP */  

  Set_USBClock();
  USB_Interrupts_Config();
  USB_Init();
}

/*******************************************************************************
* Function Name  : Set_USBClock
* Description    : Configures USB Clock input (48MHz)
* Input          : None.
* Return         : None.
*******************************************************************************/
void Set_USBClock(void)
{
  //Пускай у нас 8 Мгц кварц   
  //PLLMUL=12 , PLLDIV=3
  // 48 Mhz USB clock, 32 Mhz core clock
  RCC_APB1PeriphClockCmd(RCC_APB1Periph_USB, ENABLE);
}

/*******************************************************************************
* Function Name  : Enter_LowPowerMode
* Description    : Power-off system clocks and power while entering suspend mode
* Input          : None.
* Return         : None.
*******************************************************************************/
void Enter_LowPowerMode(void)
{
  /* Set the device state to suspend */
  bDeviceState = SUSPENDED;
}

/*******************************************************************************
* Function Name  : Leave_LowPowerMode
* Description    : Restores system clocks and power while exiting suspend mode
* Input          : None.
* Return         : None.
*******************************************************************************/
void Leave_LowPowerMode(void)
{
  DEVICE_INFO *pInfo = &Device_Info;

  /* Set the device state to the correct state */
  if (pInfo->Current_Configuration != 0)
  {
    /* Device configured */
    bDeviceState = CONFIGURED;
  }
  else
  {
    bDeviceState = ATTACHED;
  }
}

/*******************************************************************************
* Function Name  : USB_Interrupts_Config
* Description    : Configures the USB interrupts
* Input          : None.
* Return         : None.
*******************************************************************************/
void USB_Interrupts_Config(void)
{
  NVIC_InitTypeDef NVIC_InitStructure;

  NVIC_PriorityGroupConfig(NVIC_PriorityGroup_1);

#if defined(STM32L1XX_MD) || defined(STM32L1XX_HD) || defined(STM32L1XX_MD_PLUS) 
  NVIC_InitStructure.NVIC_IRQChannel = USB_LP_IRQn;
  NVIC_InitStructure.NVIC_IRQChannelPreemptionPriority = 1;
  NVIC_InitStructure.NVIC_IRQChannelSubPriority = 0;
  NVIC_InitStructure.NVIC_IRQChannelCmd = ENABLE;
  NVIC_Init(&NVIC_InitStructure);
  
#elif defined(STM32F10X_CL) 
  /* Enable the USB Interrupts */
  NVIC_InitStructure.NVIC_IRQChannel = OTG_FS_IRQn;
  NVIC_InitStructure.NVIC_IRQChannelPreemptionPriority = 1;
  NVIC_InitStructure.NVIC_IRQChannelSubPriority = 0;
  NVIC_InitStructure.NVIC_IRQChannelCmd = ENABLE;
  NVIC_Init(&NVIC_InitStructure);
  
#else
  NVIC_InitStructure.NVIC_IRQChannel = USB_LP_CAN1_RX0_IRQn;
  NVIC_InitStructure.NVIC_IRQChannelPreemptionPriority = 1;
  NVIC_InitStructure.NVIC_IRQChannelSubPriority = 0;
  NVIC_InitStructure.NVIC_IRQChannelCmd = ENABLE;
  NVIC_Init(&NVIC_InitStructure);
#endif /* STM32L1XX_XD */

}

/*******************************************************************************
* Function Name  : USB_Cable_Config
* Description    : Software Connection/Disconnection of USB Cable
* Input          : None.
* Return         : Status
*******************************************************************************/
void USB_Cable_Config (FunctionalState NewState)
{
#if defined(STM32L1XX_MD) || defined (STM32L1XX_HD)|| (STM32L1XX_MD_PLUS)
  if (NewState != DISABLE)
  {
    SYSCFG_USBPuCmd(ENABLE);
  }
  else
  {
    SYSCFG_USBPuCmd(DISABLE);
  }  

#elif defined(USE_STM3210C_EVAL)  
  if (NewState != DISABLE)
  {
    USB_DevConnect();
  }
  else
  {
    USB_DevDisconnect();
  }
  
#else /* USE_STM3210B_EVAL or USE_STM3210E_EVAL */
/*
  if (NewState != DISABLE)
  {
    GPIO_ResetBits(USB_DISCONNECT, USB_DISCONNECT_PIN);
  }
  else
  {
    GPIO_SetBits(USB_DISCONNECT, USB_DISCONNECT_PIN);
  }
*/
#endif /* USE_STM3210C_EVAL */
}

/*******************************************************************************
* Function Name  : HexToChar.
* Description    : Convert Hex 32Bits value into char.
* Input          : None.
* Output         : None.
* Return         : None.
*******************************************************************************/
static void IntToUnicode (uint32_t value , uint8_t *pbuf , uint8_t len)
{
  uint8_t idx = 0;
  
  for( idx = 0 ; idx < len ; idx ++)
  {
    if( ((value >> 28)) < 0xA )
    {
      pbuf[ 2* idx] = (value >> 28) + '0';
    }
    else
    {
      pbuf[2* idx] = (value >> 28) + 'A' - 10; 
    }
    
    value = value << 4;
    
    pbuf[ 2* idx + 1] = 0;
  }
}

/*******************************************************************************
* Function Name  : Get_SerialNum.
* Description    : Create the serial number string descriptor.
* Input          : None.
* Output         : None.
* Return         : None.
*******************************************************************************/
void Get_SerialNum(void)
{
  uint32_t Device_Serial0, Device_Serial1, Device_Serial2;

#if defined(STM32L1XX_MD) || defined(STM32L1XX_HD) || defined(STM32L1XX_MD_PLUS) 
  Device_Serial0 = *(uint32_t*)(0x1FF80050);
  Device_Serial1 = *(uint32_t*)(0x1FF80054);
  Device_Serial2 = *(uint32_t*)(0x1FF80064);
#else  
  Device_Serial0 = *(__IO uint32_t*)(0x1FFFF7E8);
  Device_Serial1 = *(__IO uint32_t*)(0x1FFFF7EC);
  Device_Serial2 = *(__IO uint32_t*)(0x1FFFF7F0);
#endif /* STM32L1XX_XD */  

  Device_Serial0 += Device_Serial2;

  if (Device_Serial0 != 0)
  {
    IntToUnicode (Device_Serial0, &Virtual_Com_Port_StringSerial[2] , 8);
    IntToUnicode (Device_Serial1, &Virtual_Com_Port_StringSerial[18], 4);
  }
}

/*******************************************************************************
* Function Name  : Send DATA .
* Description    : send the data received from the STM32 to the PC through USB  
* Input          : None.
* Output         : None.
* Return         : None.
*******************************************************************************/
uint32_t CDC_Send_DATA (uint8_t *ptrBuffer, uint8_t Send_length)
{
  /*if max buffer is Not reached*/
  if(Send_length < VIRTUAL_COM_PORT_DATA_SIZE)     
  {
    /*Sent flag*/
    packet_sent = 0;
    /* send  packet to PMA*/
    UserToPMABufferCopy((unsigned char*)ptrBuffer, ENDP1_TXADDR, Send_length);
    SetEPTxCount(ENDP1, Send_length);
    SetEPTxValid(ENDP1);
  }
  else
  {
    return 0;
  } 
  return 1;
}

/*******************************************************************************
* Function Name  : Receive DATA .
* Description    : receive the data from the PC to STM32 and send it through USB
* Input          : None.
* Output         : None.
* Return         : None.
*******************************************************************************/
uint32_t CDC_Receive_DATA(void)
{ 
  /*Receive flag*/
  packet_receive = 0;
  SetEPRxValid(ENDP3); 
  return 1 ;
}
