alxsh/balmer-usb-sdr/mcode/inc/main.h

/**
  ******************************************************************************
  * @file    Project/STM32L1xx_StdPeriph_Template/main.h 
  * @author  MCD Application Team
  * @version V1.0.3
  * @date    May-2013
  * @brief   Header for main.c module
  ******************************************************************************
  * @attention
  *
  * THE PRESENT FIRMWARE WHICH IS FOR GUIDANCE ONLY AIMS AT PROVIDING CUSTOMERS
  * WITH CODING INFORMATION REGARDING THEIR PRODUCTS IN ORDER FOR THEM TO SAVE
  * TIME. AS A RESULT, STMICROELECTRONICS SHALL NOT BE HELD LIABLE FOR ANY
  * DIRECT, INDIRECT OR CONSEQUENTIAL DAMAGES WITH RESPECT TO ANY CLAIMS ARISING
  * FROM THE CONTENT OF SUCH FIRMWARE AND/OR THE USE MADE BY CUSTOMERS OF THE
  * CODING INFORMATION CONTAINED HEREIN IN CONNECTION WITH THEIR PRODUCTS.
  *
  * <h2><center>&copy; COPYRIGHT 2010 STMicroelectronics</center></h2>
  ******************************************************************************
  */ 
  
#ifndef __MAIN_H
#define __MAIN_H

#include "stm32l1xx.h"
#include <stdio.h>

extern RCC_ClocksTypeDef RCC_Clocks;

#endif /* __MAIN_H */
