alxsh/balmer-usb-sdr/4code/inc/spi_commands.h

typedef enum SPI_COMMANDS
{
	SCOMMAND_NONE = 0,
	SCOMMAND_TMP = 1,
	SCOMMAND_SOUND_BUF_DELTA = 2,
	SCOMMAND_FFT_MIN_MAX = 3,
	SCOMMAND_FFT_LINE = 4,
	SCOMMAND_SIDE_BAND = 5,
} SPI_COMMANDS;
