alxsh/balmer-usb-sdr/4code/src/process_fft.c

#include "dac.h"
#include "process_sound.h"
#include "arm_math.h"
#include "delay.h"

#include <limits.h>
#include <math.h>



//static arm_rfft_instance_f32 S_RFFT;
static arm_cfft_radix4_instance_f32 S_CFFT;
static int32_t in_fft_buffer32[FFT_LENGTH];
static float in_fft_buffer[FFT_LENGTH*2];
static float out_fft_buffer[FFT_LENGTH*2];
uint16_t fft_calculate_time = 0;
static int in_fft_cur_pos = 0;
int32_t g_fft_min = 0;
int32_t g_fft_max = 0;

uint16_t fft_to_display[FFT_LENGTH];

void CalculateFft();

void OnSoundDataFft(int32_t sampleQ, int32_t sampleI)
{
	if(in_fft_cur_pos<FFT_LENGTH)
	{
		in_fft_buffer32[in_fft_cur_pos] = (sampleQ>>8);
		in_fft_cur_pos++;
	}
}

void InitFft()
{
	for(int i=0; i<FFT_LENGTH; i++)
	{
		in_fft_buffer[i*2+0] = 0.0f;
		in_fft_buffer[i*2+1] = 0.0f;
		fft_to_display[0] = 0;
	}

	g_fft_min = g_fft_max = 0;

	in_fft_cur_pos = 0;

	uint32_t ifftFlag = 0; 
	uint32_t doBitReverse = 1;
	arm_cfft_radix4_init_f32(&S_CFFT, FFT_LENGTH,
	  								ifftFlag, doBitReverse); 

}

void CalculateFft()
{
	if(in_fft_cur_pos<FFT_LENGTH)
		return;

	if(0)
	{
		DelayUs(300);
		in_fft_cur_pos = 0;
		return;
	}

	int32_t smin = INT_MAX;
	int32_t smax = INT_MIN;

	uint16_t start = TimeUs();
	for(int i=0; i<FFT_LENGTH; i++)
	{
		int32_t s = in_fft_buffer32[i];
		if(smin>s)
			smin = s;
		if(smax<s)
			smax = s;
		in_fft_buffer[i*2] = s;
		in_fft_buffer[i*2+1] = 0;
	}
	
	arm_cfft_radix4_f32(&S_CFFT, in_fft_buffer); 
	arm_cmplx_mag_f32(in_fft_buffer, out_fft_buffer, FFT_LENGTH);  

	int32_t omax = 0;
	float fmul = 10.0f/logf(2);
	for(int i=0; i<FFT_LENGTH; i++)
	{
		//int32_t o = lround(out_fft_buffer[i]);
		//fft_to_display[i] = lround(out_fft_buffer[i]*1e-2f);

		float f = out_fft_buffer[i];
		int32_t o = lround(logf(f+1)*fmul);
		fft_to_display[i] = o;

		if(omax < o)
			omax = o;
	}
	
	//g_fft_min = lround(sum/(float)FFT_LENGTH);
	g_fft_min = smax-smin;
	//g_fft_max = (uint16_t)(TimeUs()-start);
	g_fft_max = omax;

	//uint16_t start = TimeUs();
	//arm_rfft_f32(&S_RFFT, in_fft_buffer, out_fft_buffer);
	//out_fft_buffer[0] = in_fft_buffer[0]+in_fft_buffer[1];
	//fft_calculate_time =  TimeUs()-start;

	//g_fft_min = INT_MAX;
	//g_fft_max = INT_MIN;

	in_fft_cur_pos = 0;
}
