alxsh/balmer-usb-sdr/mcode/src/commands.c

#include "hw_config.h"
#include "data_process.h"
#include "ili/UTFT.h"
#include "spi_data_process.h"
#include "../../4code/inc/spi_commands.h"

void OnSetFreq(uint32_t freq);
void OnSideBand(uint8_t usb);

uint16_t g_spi_sended = 0;
uint16_t g_spi_retry = 0;

void PacketReceive(volatile uint8_t* data, uint32_t size)
{
	uint8_t command = data[0];
	data++;
	size--;

	switch(command)
	{
	case 1://COMMAND_PRINT_INT
		{
			volatile int value = *(int*)(data+0);
			volatile int x = *(int*)(data+4);
			volatile int y = *(int*)(data+8);
			
			UTFT_printNumI(value,
						   x,
						   y, 0, ' ');
		}
		return;

	case 2://COMMAND_SEND_SPI
		{
			g_spi_sended = *(uint16_t*)(data+0);
			g_spi_retry = 10;
			SpiAdd16(g_spi_sended);
			SpiSendCommand(2);
		}
		return;
	case 3://COMMAND_SET_FREQ
		OnSetFreq(*(uint32_t*)(data+0));
		return;

	case 4://COMMAND_SIDE_BAND
		OnSideBand(data[0]);
		return;

	case 0://COMMAND_NONE
	default:
		USBAdd8(command);
		USBAdd32(size);
		USBSend();
		break;
	}

}
