alxsh/balmer-usb-sdr/code/mycode/inc/hw_config.h

#ifndef __HW_CONFIG_H
#define __HW_CONFIG_H

/* Includes ------------------------------------------------------------------*/
#include "usb_type.h"

/* Exported functions ------------------------------------------------------- */
void UsbInitClockAndSystem(void);
void Enter_LowPowerMode(void);
void Leave_LowPowerMode(void);
void USB_Cable_Config (FunctionalState NewState);

void Get_SerialNum(void);

uint32_t CDC_Send_DATA (uint8_t *ptrBuffer, uint8_t Send_length);
uint32_t CDC_Receive_DATA(void);


#endif  /*__HW_CONFIG_H*/
