alxsh/balmer-usb-sdr/(commit log)

2014-07-03 - first commit - uncomplete schematic
    [mini.sch]
2014-07-03 - enable serial mode
    [mini.sch]
2014-07-04 - change connector
    [mini.sch]
2014-07-05 - ????????? ??????????? AD9850 ??????
    [mini.brd, mini.sch]
2014-07-08 - ?????????????????? ?? ??????? 85x60??
    [mini.brd]
2014-07-09 - ???????? ????? ??????? ? ????????? ???????? 78x61 ??
    [mini.brd]
2014-07-09 - ????? ??? USB ?????
    [mini.brd]
2014-07-15 - ?????????? USB ? ????????? ??????? ??? AD9850
    [mini.brd, mini.sch]
2014-07-21 - ????????? ????? - ?????????? ?????????? ?????? ??? IC5
    [mini.brd, mini.sch]
2014-09-06 - ?????????? SDR audio ??? ????, ????? ????? ??????? ?????????? ?
    [mini.brd, mini.sch]
2014-09-09 - ?????-???? ???????????? ????? ??? AD9958
    [dds_ad9958.sch]
2014-09-09 - renumber
    [dds_ad9958.sch]
2014-09-10 - ???????? ??????? AD9958
    [dds_ad9958.brd, dds_ad9958.sch]
2014-09-28 - CS4272 test board
    [cs4272_test.sch, dds_ad9958.brd, dds_ad9958.sch]
2014-10-15 - balmer.lbr CS4272 - STM32F405RGT6
    [cs4272_test.sch]
2014-10-25 - ?????? ???????? DSP ??????
    [ADC_DSP.sch]
2014-10-26 - ??????? 51x57 ??
    [ADC_DSP.brd]
2014-10-26 - 43x55 ??
    [ADC_DSP.brd]
2014-10-28 - ????? ? ?????????? GND ? AGND
    [ADC_DSP.brd]
2014-11-02 - ????? ?????????? ?????? - ?????????? DelayUs, DelayMs. ????????? ?????? ? DelayUs ??-?? ??????? ?? ?????? ?? ??? ?????? (?????????? ? uint16_t) - ??? DAC ?????? ???????????? ???????, ?? ??? ???? ??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
    [ADC_DSP.brd]
2014-11-03 - R3 3.3 KOm -> 33 KOm C2 10 nF -> 1 nF - ???????? ??? ??? ?? ????????? DAC
    [ADC_DSP.brd, ADC_DSP.sch]
2014-11-03 - SPI master 125 KHz
2014-11-03 - spi ??? STM32F405 (???? Master)
2014-11-04 - ?????????? ????? SPI - ??-?? ??????? ??????? ???????? ??? ?????????? ???? ?????? ???????? . ????????? GPIO_Speed_2MHz
2014-11-08 - SPI ???????? ?? ??????? 16 ??? (master SPI_BaudRatePrescaler_2)
2014-11-08 - ??????? ?? SPI ?????-????? ??????????/???????????
2014-11-08 - ????????? SPI ?????
2014-11-09 - ????? ?????????? CS4272 DMA
2014-11-09 - ????????? ?????????? CS4272 DMA RX
2014-11-11 - ???? ????? ?????????? DMA ???
2014-11-11 - ?????-????? ?????????? DMA
2014-11-13 - ????? ??????? ????????????? ADC / DAC ??????? ???? ???????
2014-11-25 - ??????? +-5V
    [dual_supply.brd, dual_supply.sch]
2014-12-01 - ?????????? DDS ??????????. - ????????? ???????
    [mixer.brd, mixer.sch]
2015-01-14 - ???????? ???????????? ADC_DSP.sch
    [ADC_DSP.brd, ADC_DSP.sch]
